polyfloyd/led-pad/(commit log)

2018-07-22 Speed up rendering and stabilise cursor
    [led-pad.ino]
2018-07-22 Fix color mapping and push MQTT messages
    [led-pad.ino]
2018-07-22 Implement the Party button
2018-07-22 Update wiring for final assembly
